bazilbasi726/Modification-of-a-Heating-unit---RS-PRO-Soldering-Station-700W/MasterThesis_HeatingUnit_System/Construction Manual/Heating Unit construction manual .pdf

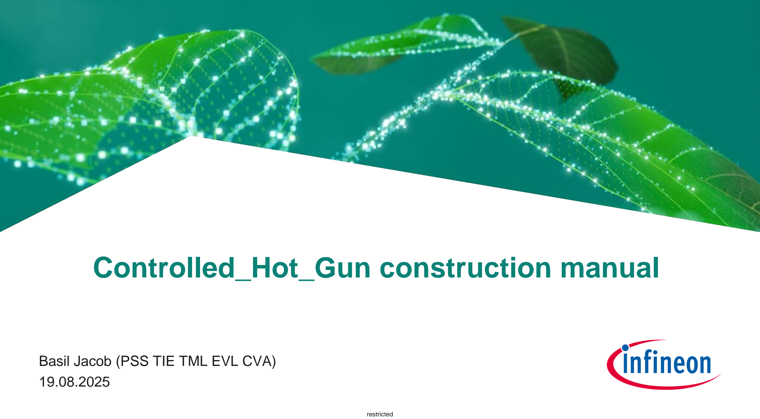
[picture p1: page 1]

restricted | 1

## Basil Jacob (PSS TIE TML EVL CVA)

19.08.2025

# Controlled_Hot_Gun construction manual

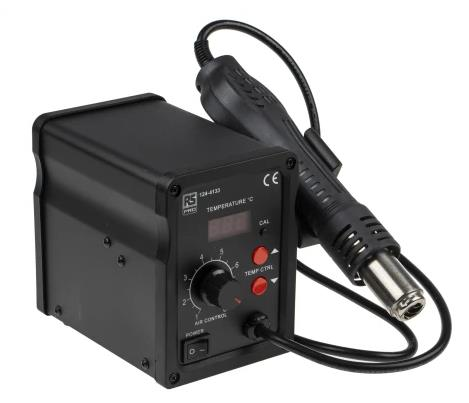
[picture p2: figure]

18 Mrz 2023 | restricted | Copyright © Infineon Technologies AG 2023. All rights reserved. | 2

# Disassemble the RS Soldering station

https://at.rs-online.com/web/p/lotstationen/1244133

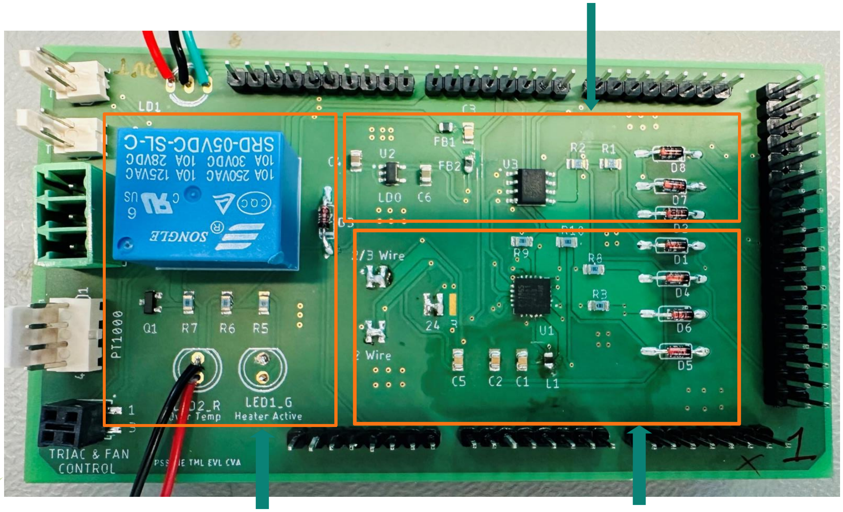
[picture p3: figure]

18 Mrz 2023 | restricted | Copyright © Infineon Technologies AG 2023. All rights reserved. | 3

# Prepare Arduino Mega Compatible Controller Board

### From DUT Thermocouple

## From mains supply

From PT1000,

## To Main PCB (Adapter)

Protection Circuit | MAX31865 for PT1000

1

2

3

4

### From HotgunThermocouple

5

## MAX31855 for Thermocuple

After soldering mount
controller board on an
Arduino Mega 2560 | Z:\_Messtechnik\Diplomarbeiten\Jacob Basil\Find Useful files\Eagle files\Controller_Board_PCB

# Solder Jumpers

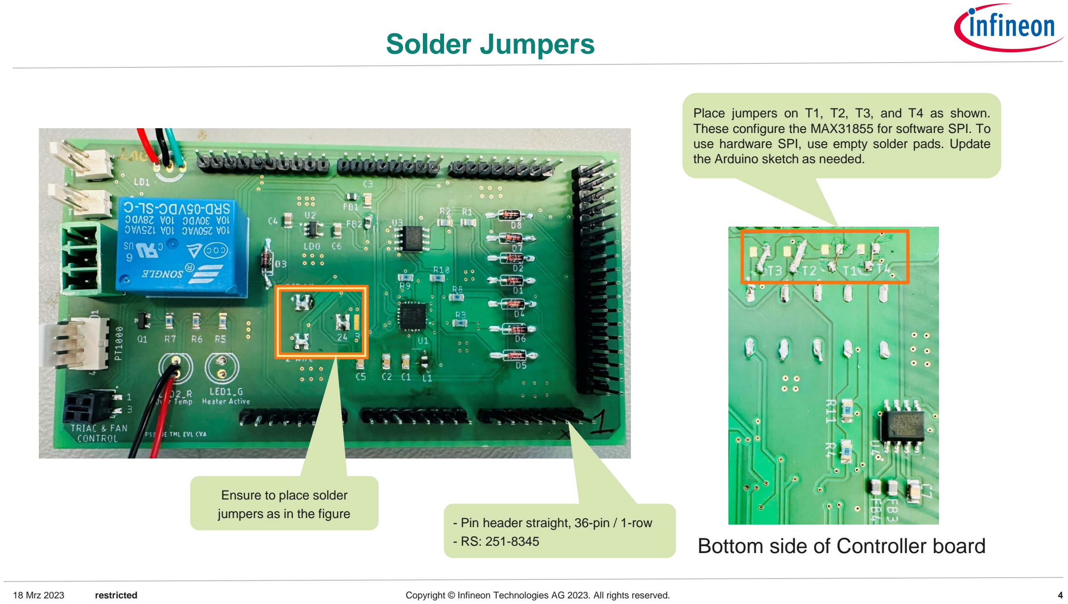
[picture p4: page 4]

18 Mrz 2023 | restricted | Copyright © Infineon Technologies AG 2023. All rights reserved. | 4

Ensure to place solder
jumpers as in the figure

Place jumpers on T1, T2, T3, and T4 as shown. These configure the MAX31855 for software SPI. To use hardware SPI, use empty solder pads. Update the Arduino sketch as needed.

## Bottom side of Controller board

- Pin header straight, 36-pin / 1-row
- RS: 251-8345

# Adapter that connects Main PCB to controller

## Controller PCB

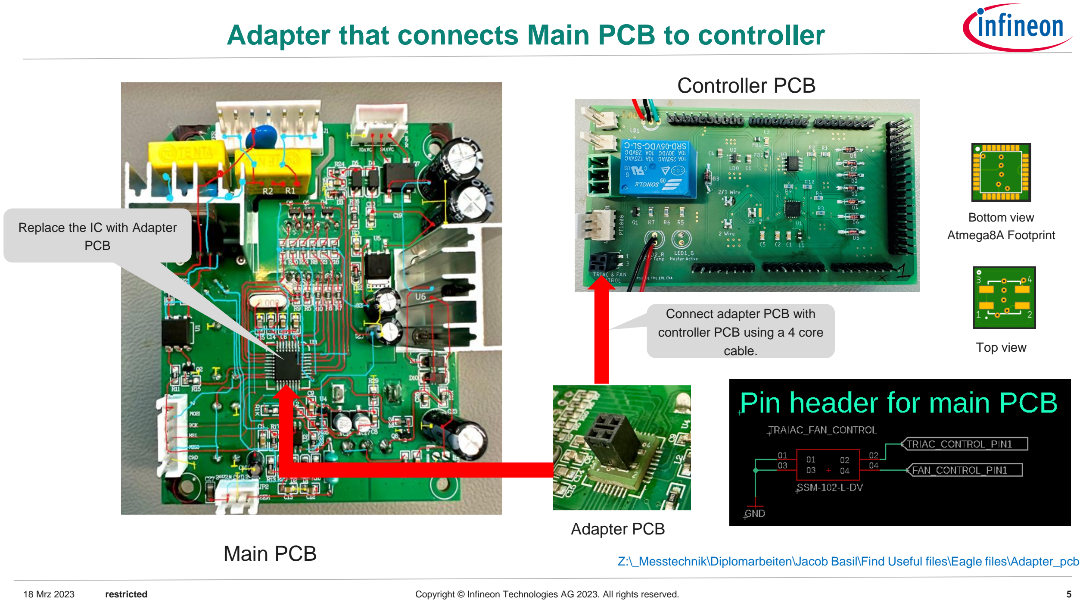
[picture p5: page 5]

18 Mrz 2023 | restricted | Copyright © Infineon Technologies AG 2023. All rights reserved. | 5

Bottom view
Atmega8A Footprint

Top view

### Adapter PCB

## Main PCB

Connect adapter PCB with
controller PCB using a 4 core cable.

Replace the IC with Adapter PCB

Z:\_Messtechnik\Diplomarbeiten\Jacob Basil\Find Useful files\Eagle files\Adapter_pcb

# Mount PCB and connectors for sensors

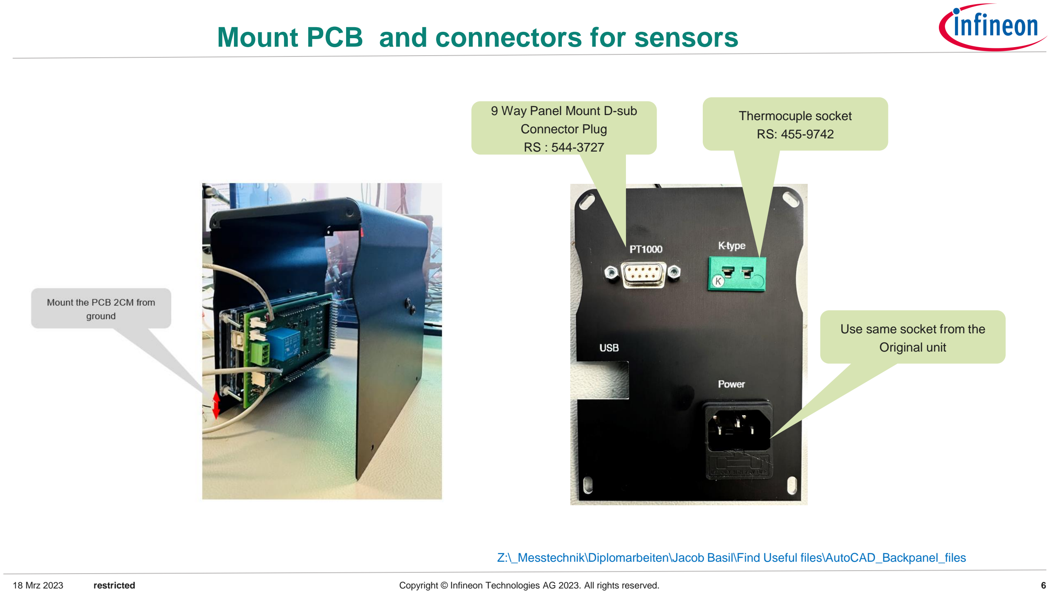
[picture p6: page 6]

18 Mrz 2023 | restricted | Copyright © Infineon Technologies AG 2023. All rights reserved. | 6

Use same socket from the
Original unit

Thermocuple socket
RS: 455-9742

9 Way Panel Mount D-sub
Connector Plug
RS : 544-3727

Z:\_Messtechnik\Diplomarbeiten\Jacob Basil\Find Useful files\AutoCAD_Backpanel_files

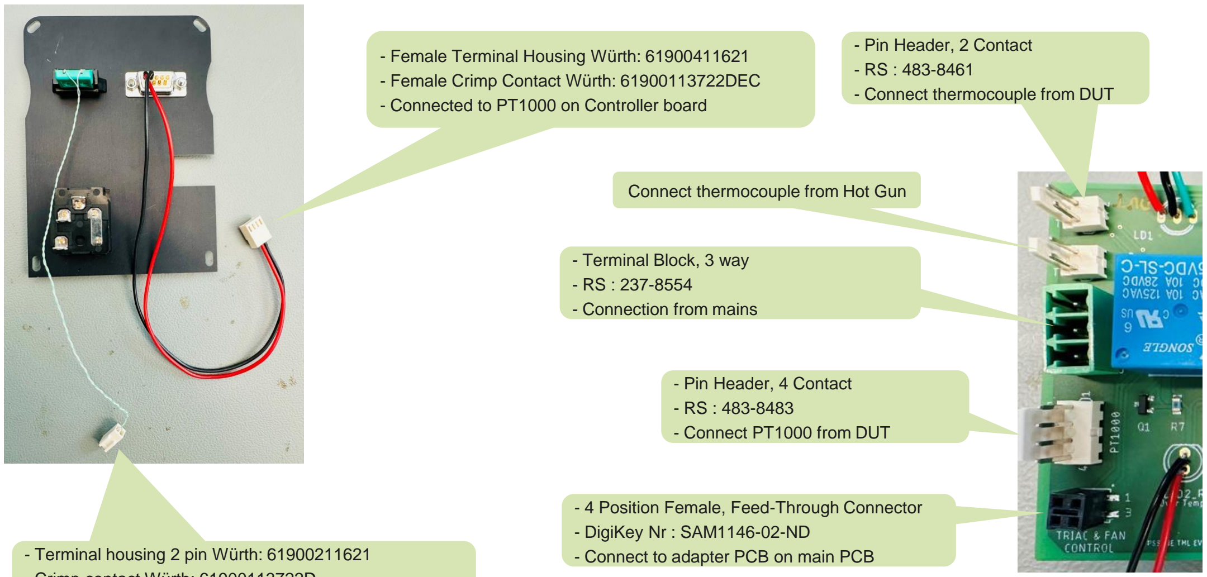
[picture p7: figure]
- Pin Header, 2 Contact; - Connect thermocouple from DUT; - Pin Header, 4 Contact; - Connect PT1000 from DUT; - Terminal Block, 3 way - RS : 237-8554; - Connection from mains; Connect thermocouple from Hot Gun; - DigiKey Nr : SAM1146-02-ND; - Connect to adapter PCB on main PCB

18 Mrz 2023 | restricted | Copyright © Infineon Technologies AG 2023. All rights reserved. | 7

Prapare Cables for PT1000 and Thermocuple.

- Female Terminal Housing Würth: 61900411621
- Female Crimp Contact Würth: 61900113722DEC
- Connected to PT1000 on Controller board
- Terminal housing 2 pin Würth: 61900211621
- Crimp contact Würth: 61900113722D
- Connect to JP1 on controller board (DUT thermocouple)
- 4 Position Female, Feed-Through Connector

# LED indicators & Custom Front Panel

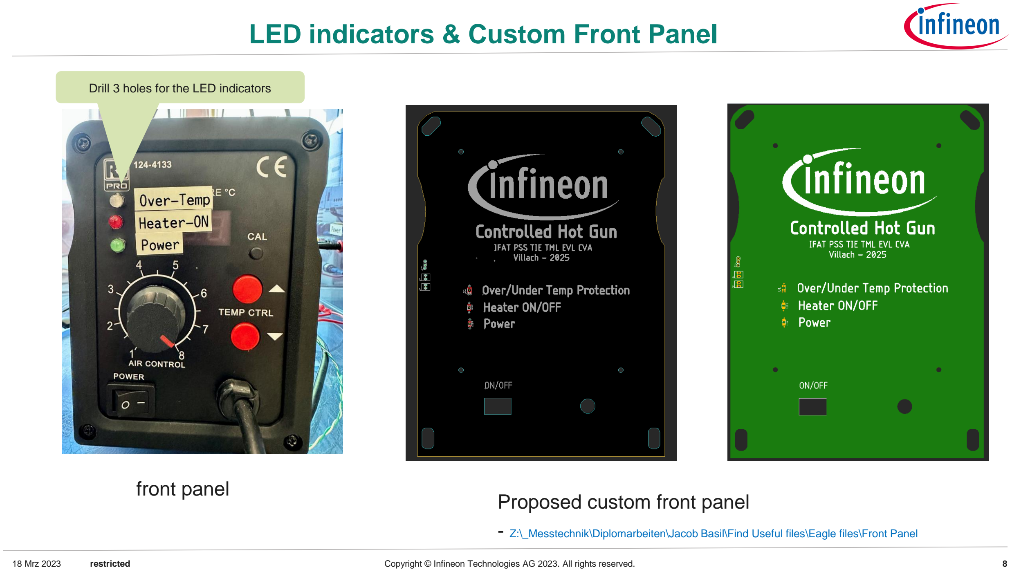
[picture p8: page 8]

18 Mrz 2023 | restricted | Copyright © Infineon Technologies AG 2023. All rights reserved. | 8

Drill 3 holes for the LED indicators

## Proposed custom front panel

- Z:\_Messtechnik\Diplomarbeiten\Jacob Basil\Find Useful files\Eagle files\Front Panel

## front panel

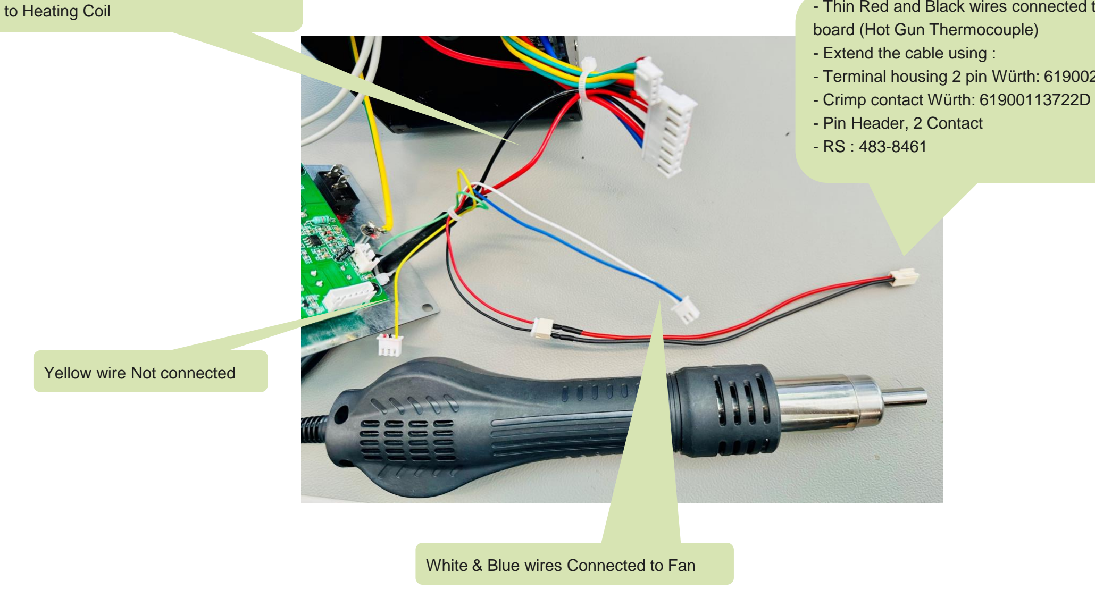
[picture p9: figure]
Yellow wire Not connected; White & Blue wires Connected to Fan; board (Hot Gun Thermocouple); - Extend the cable using :; - Crimp contact Würth: 61900113722D; - Pin Header, 2 Contact; to Heating Coil

18 Mrz 2023 | restricted | Copyright © Infineon Technologies AG 2023. All rights reserved. | 9

# Connect Hot Gun

- Thin Red and Black wires connected to Controller
- Terminal housing 2 pin Würth: 61900211621

Thick Red & Black Wires connected

# Internal wiring Diagram

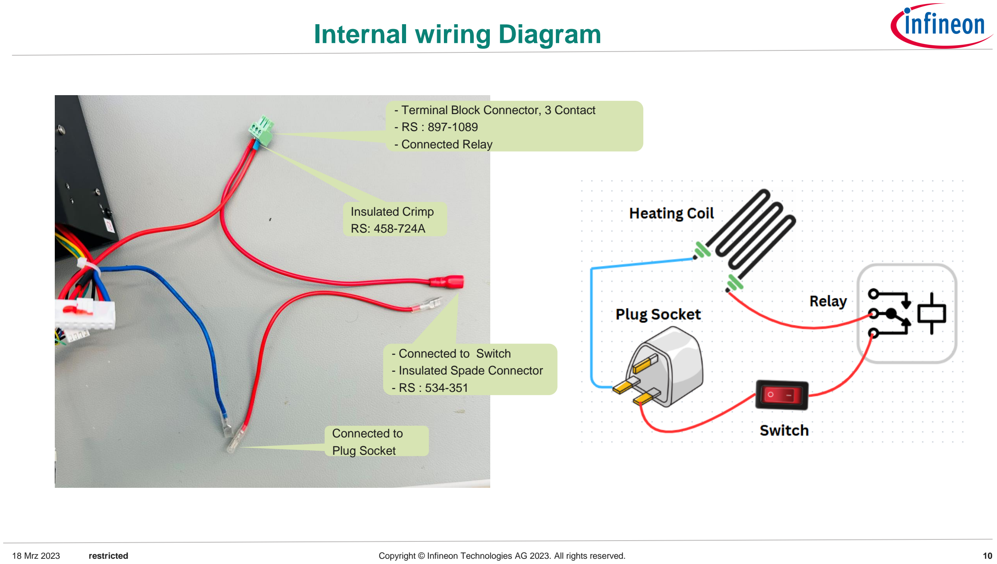
[picture p10: page 10]

18 Mrz 2023 | restricted | Copyright © Infineon Technologies AG 2023. All rights reserved. | 10
- Terminal Block Connector, 3 Contact
- RS : 897-1089
- Connected Relay

Connected to
Plug Socket
- Connected to Switch
- Insulated Spade Connector
- RS : 534-351

Insulated Crimp
RS: 458-724A

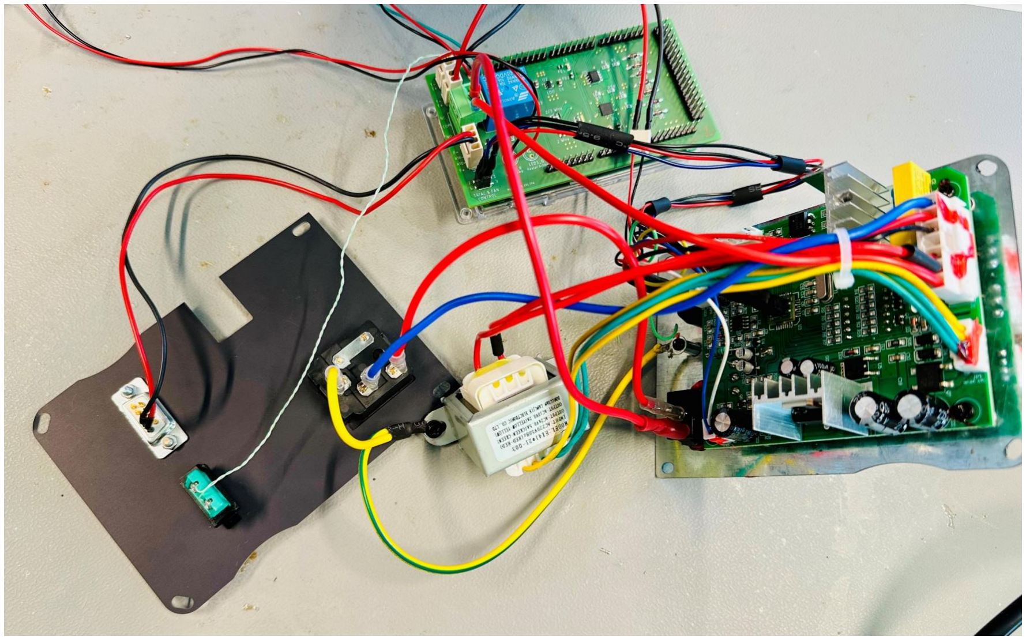
[picture p11: figure]

18 Mrz 2023 | restricted | Copyright © Infineon Technologies AG 2023. All rights reserved. | 11

# Internal Wiring, a reference

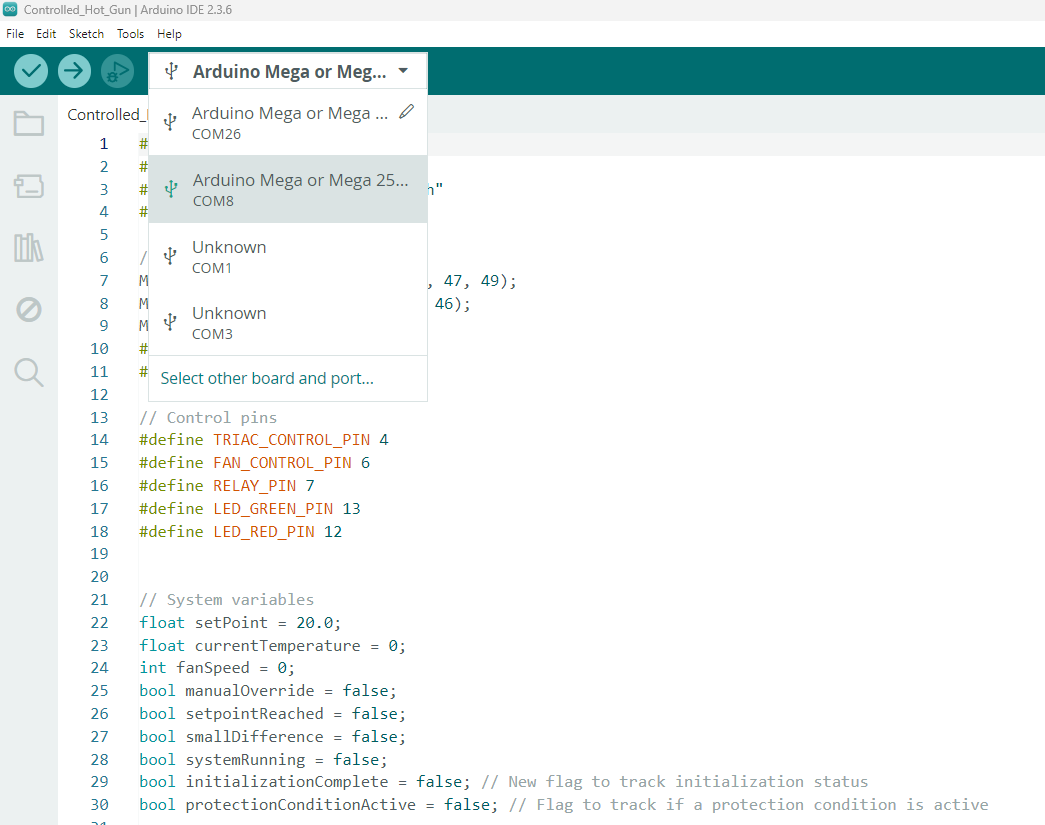
[picture p12: figure]

18 Mrz 2023 | restricted | Copyright © Infineon Technologies AG 2023. All rights reserved. | 12

# Flash MCU Firmware using Ardunio IDE

Z:\_Messtechnik\Diplomarbeiten\Jacob Basil\Find Useful files\Arduino_Sketches\Sketcht with new PCB\Controlled _Hot_Gun\Controlled_Hot_Gun

## ‒ Open the firmware for the Aruino using below given Directory (Controlled_Hot_Gun.ino) on

Arudino IDE.

## ‒ Connect Desired Arduino Mega Board on IDE ‒ Click on Upload button

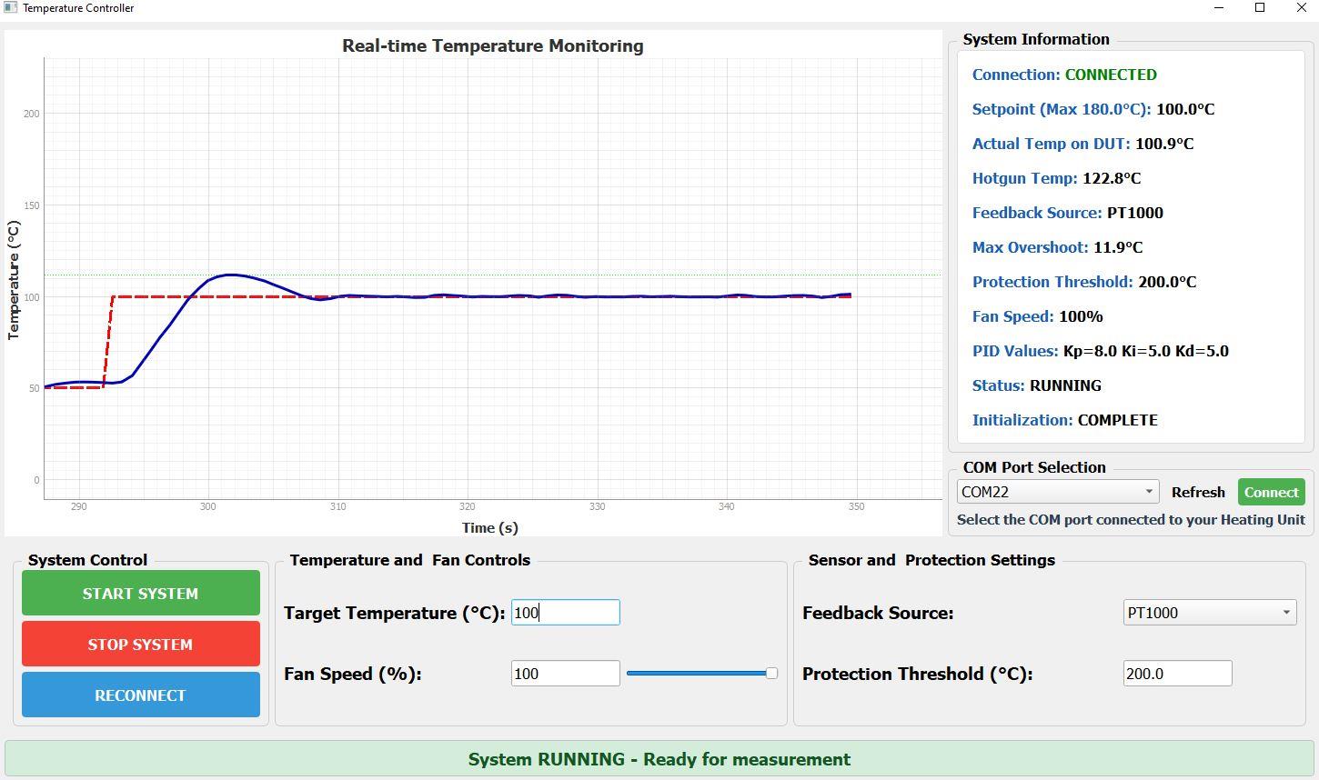
[picture p13: figure]

18 Mrz 2023 | restricted | Copyright © Infineon Technologies AG 2023. All rights reserved. | 13

# Python GUI

‒ Z:\_Messtechnik\Diplomarbeiten\Jacob Basil\Find Useful files\Python_GUI_codes\Python code for GUI

- Open The GUI Source code using below given Directory (Controlled_Hot_Gun_GUI.py) in a Code editor (eg: VS Code)
- Create an enviorment in a code editor by installing all dependencies as the code is not in a software or executable format.
- Run Python GUI Program
- Establish a connection to the Heating unit via COM Port Selection.

18 Mrz 2023 | restricted | Copyright © Infineon Technologies AG 2023. All rights reserved. | 14

## ‒ Z:\_Messtechnik\Diplomarbeiten\Jacob Basil\Find Useful files

## - Eagle files - Autocad files - BOM - Arduino Firmware - Python code for GUI

# Find useful files

18 Mrz 2023 | restricted | Copyright © Infineon Technologies AG 2023. All rights reserved. | 15

# BOM

Description | Part Number | Pcs | Vendor
Pluggable terminal block connector | 897-1089 | 1 | RS-Components
Sub-D connector E socket | 544-3749 | 1 | RS-Components
Thermocouple panel socket | 455-9742 | 1 | RS-Components
Pluggable Terminal Blocks Header | 651-1803280 | 1 | Mouser Elecetronics
Arduino Atmega 2560 development board | 715-4084 | 1 | RS-Components
RS PRO soldering station | 124-4133 | 1 | RS-Components
Sensor interface MAX31855 | 700-MAX31855KASA+ | 2 | Mouser Elecetronics
MAX31865ATP+, IC RTD TO DIGITAL CONVERT 20QFN | MAX31865ATP+-ND | 1 | Digi-Key
SMD ferrite beads | 223-4974 | 5 | RS-Components
General purpose relay 5V | 392-101287 | 1 | Mouser Elecetronics
Female Crimp Contact | 710-61900113722DEC | 8 | Mouser Elecetronics
Straight pin header | 251-8345 | 2 | RS-Components
LDO Voltage Regulator | 998-MIC5225-3.3YM5TR | 1 | Mouser Elecetronics
NPN Transistor | 753-2721 | 1 | RS-Components
Insulated Spade Connector | 534-351 | 1 | RS-Components
Insulated Crimp | 458-724A | 2 | RS-Components
Terminal housing 2 pin | 6190-0211621 | 3 | Würth Electronics
Pin Header, 2 Contact | 483-8461 | 3 | RS-Components
Pin Header, 4 Contact | 483-8483 | 1 | RS-Components
4 Position Female, Feed-Through Connector | SAM1146-02-ND | 2 | Digi-Key
Dual Colour LED Green, Red (Front Panel - Over/UnderTemp Protection) | 215-1697 | 1 | RS-Components
LED Yellow (Front Panel - Power) | 871-4631 | 1 | RS-Components
LED Red (Front Panel - Heater ON/OFF) | 871-4637 | 1 | RS-Components

Z:\_Messtechnik\Diplomarbeiten\Jacob Basil\Find Useful files\BOM

16

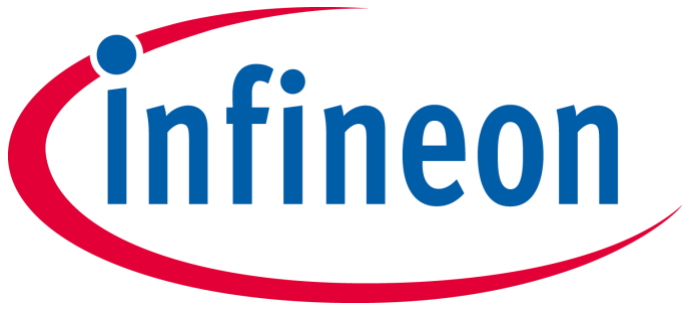
[picture p14: figure]
